UKTC-Robotics/Humanoid-arm/README.md

# Humanoid-arm
Humanoid arm - (Bulgarian Academy of Sciences)
