UKTC-Robotics/Humanoid-arm/(list of files, drawings)

Other design files:
rukavica.fzz
schematic-arm.fzz
schematic-glove.fzz
