UKTC-Robotics/Humanoid-arm/(commit log)

2018-02-22 Arduino code for HumArm
2018-02-22 Schematics
    For arm and glove
    [schematic-arm.fzz, schematic-glove.fzz]
2018-02-25 документация
2018-03-07 Arduino code
2018-03-08 arm control : python
